MadsGadeberg/MG-Gadget/Diagram/MG-Gadget Diagram.png

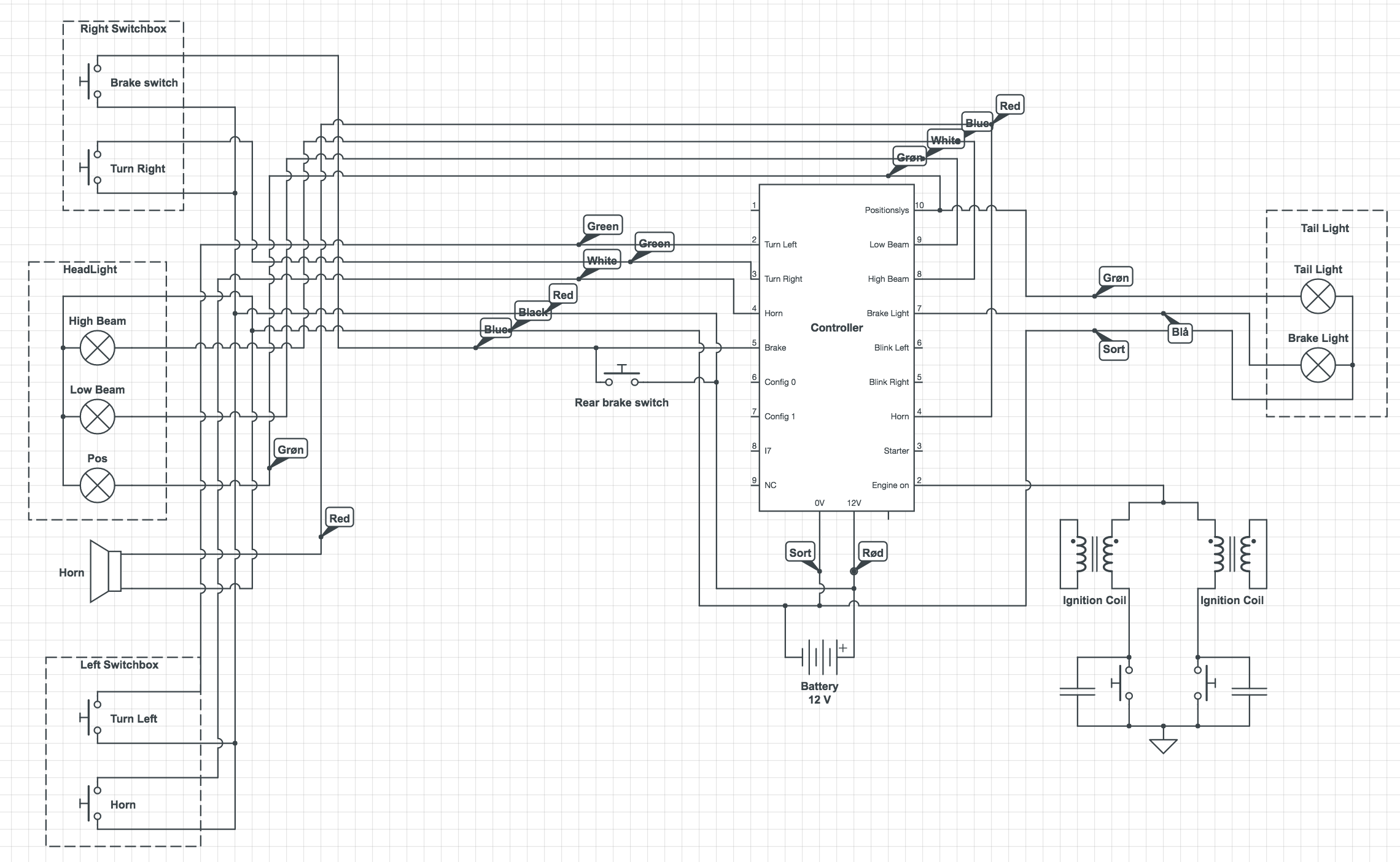
Diagram/MG-Gadget Diagram.png
