MadsGadeberg/MG-Gadget/Diagram/CB400F Diagram.pdf

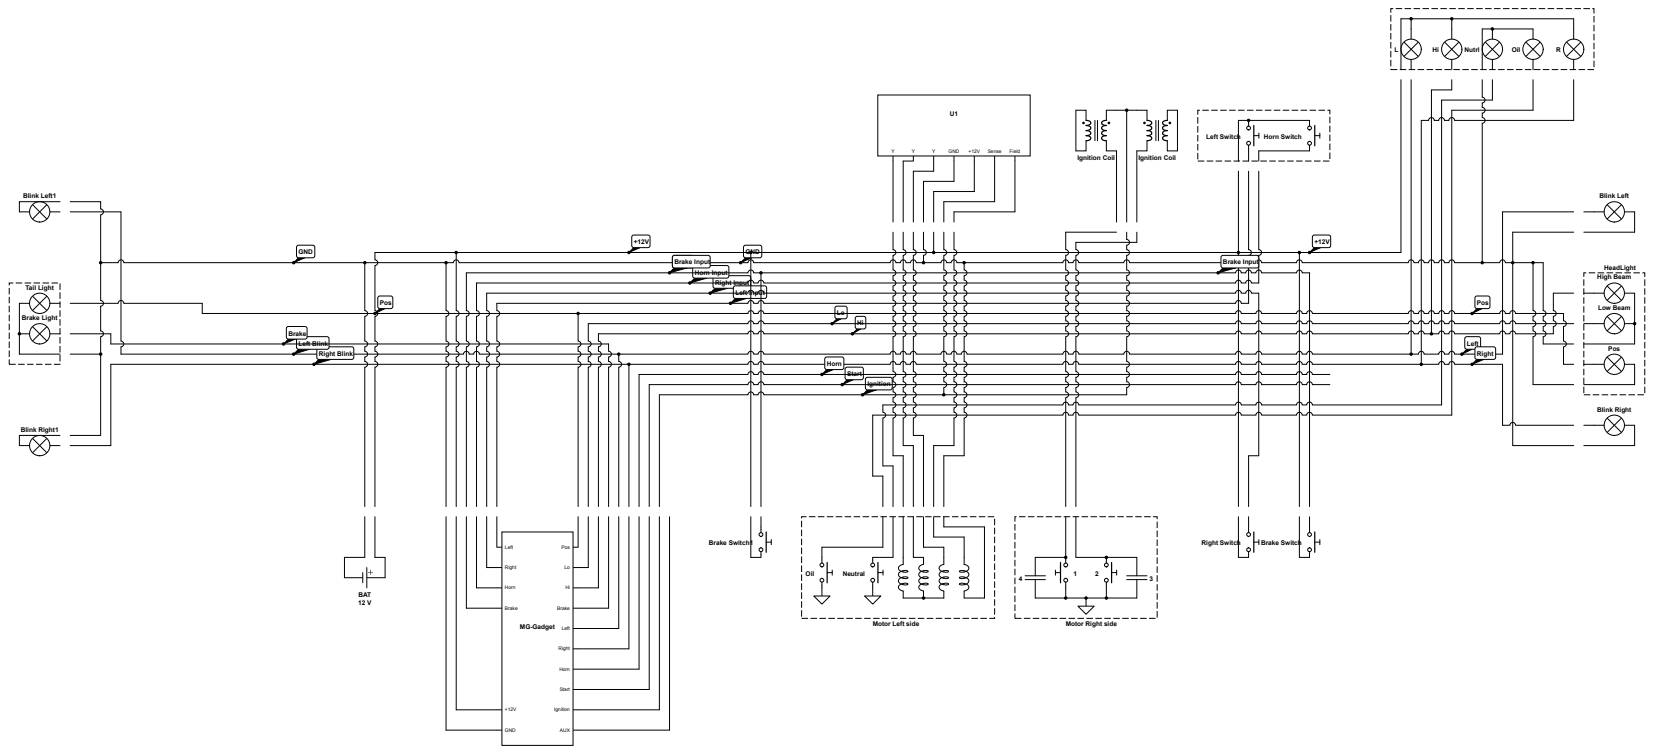
[picture p2: page 1]
GND; Sense; Field; Oil; Neutral; Ignition Coil; Motor Left side; Motor Right side; BAT 12 V; MG-Gadget; Left; Brake; Horn; Right; Pos; Start; Ignition; AUX; Right Input; Left Input; Horn Input; Right Blink; Left Blink; Brake Input; Low Beam; HeadLight High Beam; Tail Light; Brake Light; Blink Right; Blink Left; Left Switch; Horn Switch; Brake Switch1; Right Switch; Brake Switch; Blink Left1; Blink Right1; Nutrl
