MadsGadeberg/MG-Gadget/Diagram/MG-Gadget Diagram.pdf

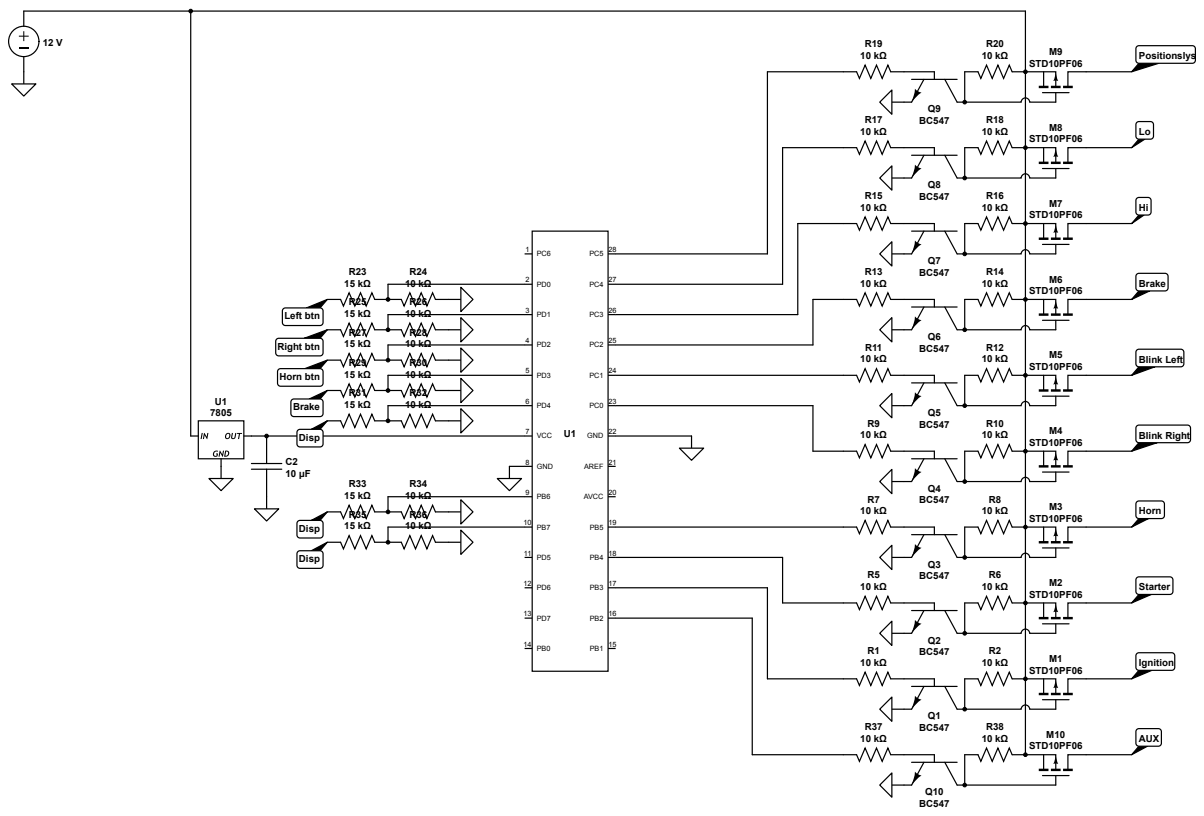
[picture p3: page 1]
