MadsGadeberg/MG-Gadget/Diagram/Old documents/CB400F Diagram.old.pdf

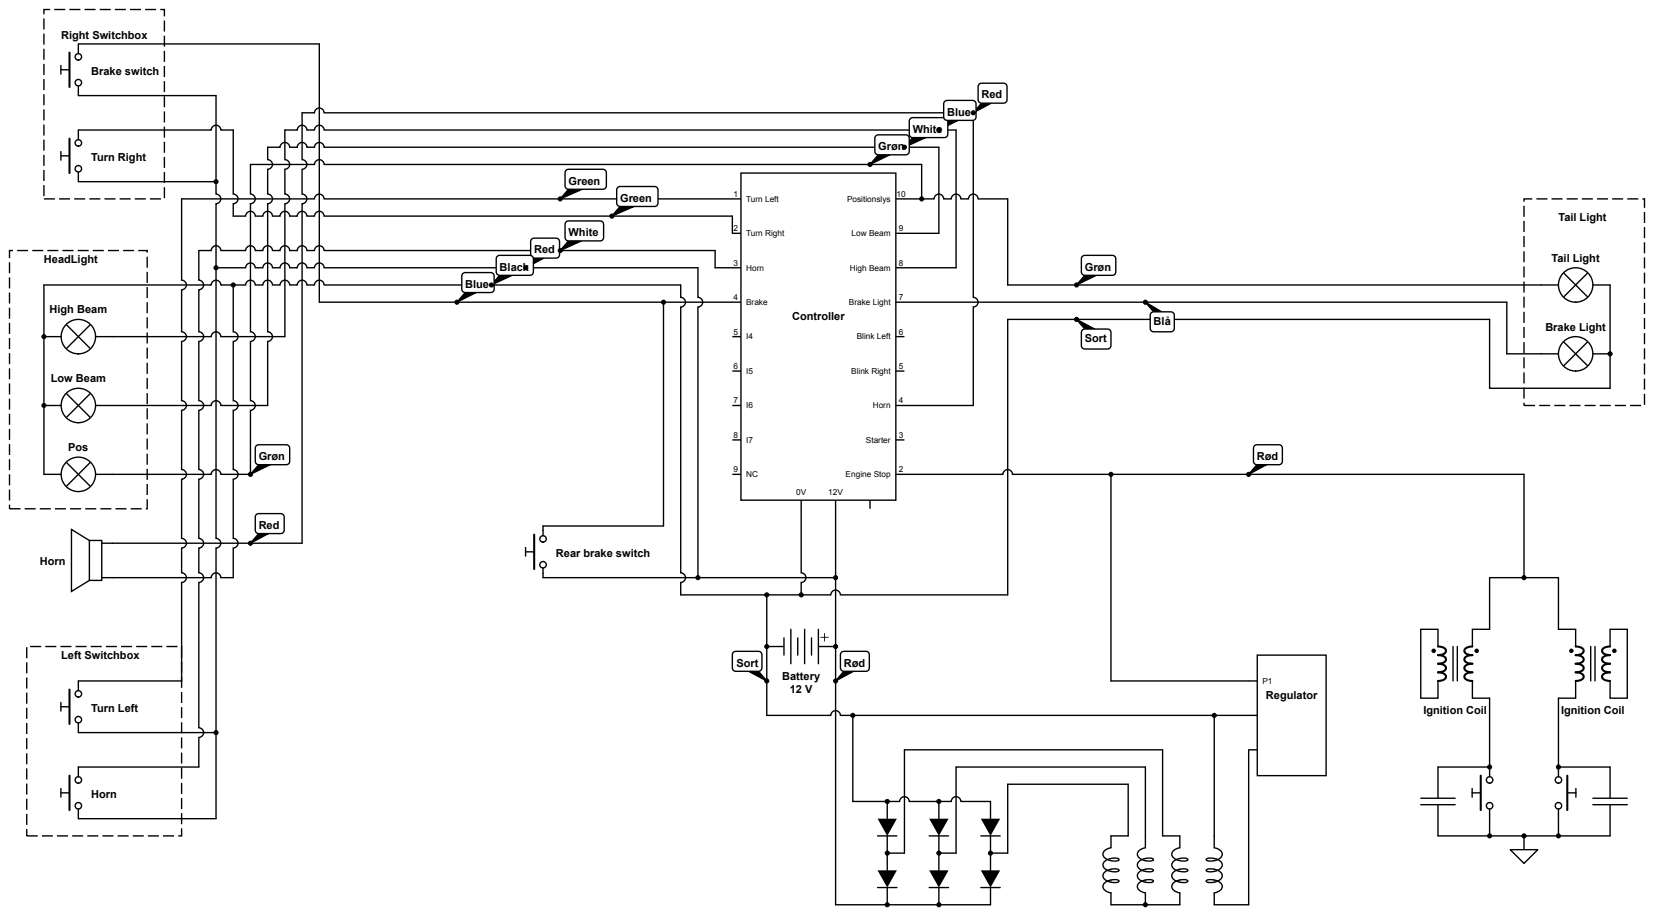
[picture p4: page 1]
Controller; Turn Left 1; Turn Right 2; Horn 3; Brake 4; Positionslys 10; Low Beam 9; High Beam 8; Brake Light 7; Blink Left 6; Blink Right 5; Horn 4; Starter 3; Engine Stop 2; Turn Left; Turn Right; Horn; Battery 12 V; High Beam; Low Beam; Pos; HeadLight; Left Switchbox; Right Switchbox; Tail Light; Brake Light; Brake switch; Ignition Coil; Regulator; Rød; Grøn; Sort; Blå; White; Blue; Red; Black; Green

Rear brake switch
