MadsGadeberg/MG-Gadget/Diagram/Old documents/MG-Gadget_diagram.outdated.pdf

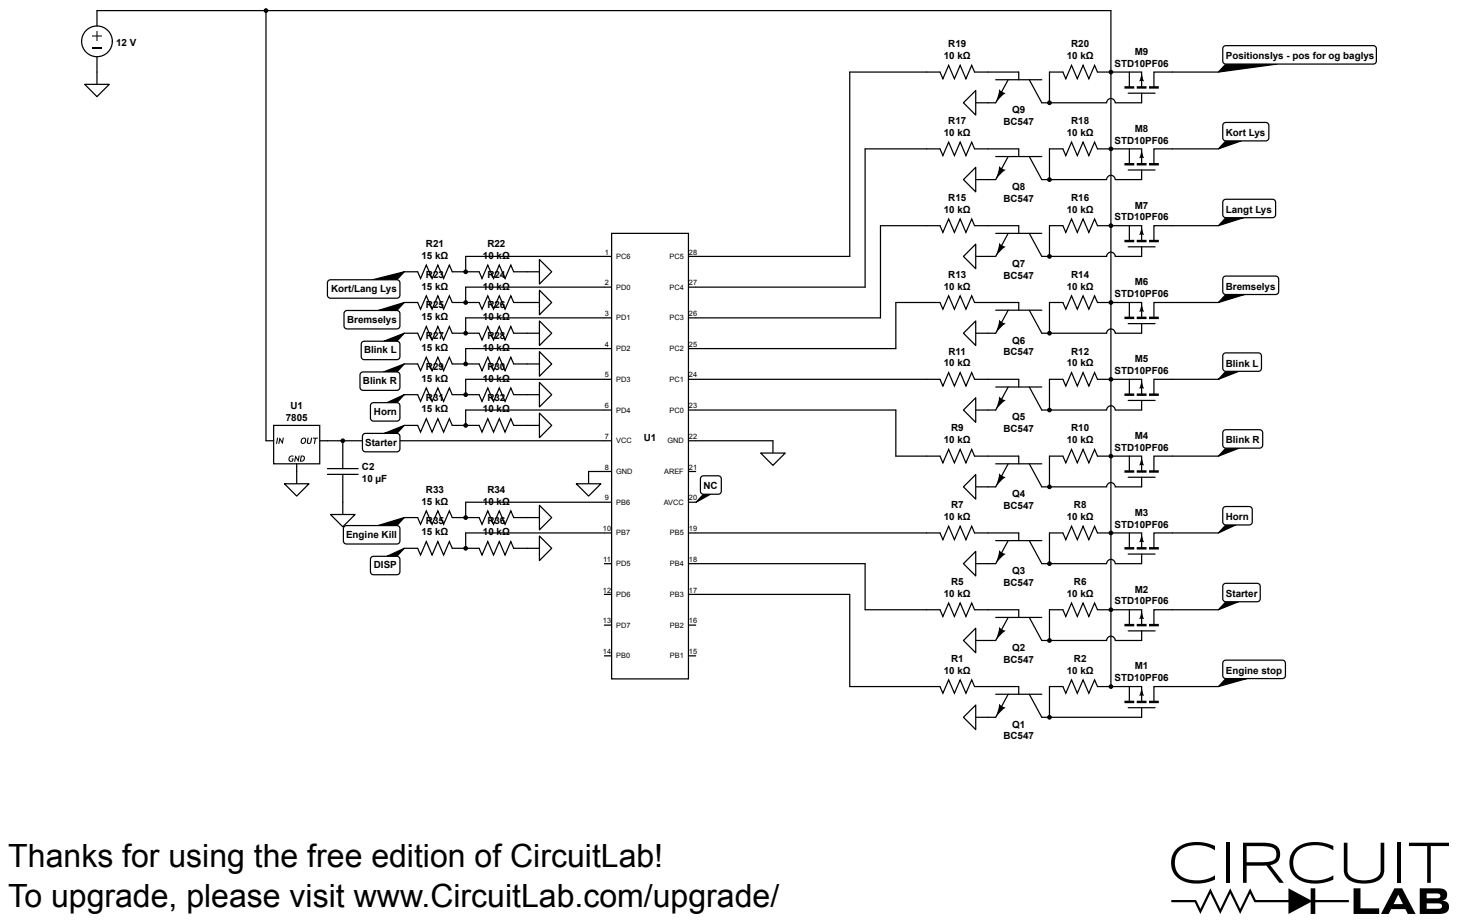
[picture p5: page 1]

Thanks for using the free edition of CircuitLab!
To upgrade, please visit www.CircuitLab.com/upgrade/
