MadsGadeberg/MG-Gadget/Eagle Projects/MG-Gadget arduino pro mini/MG-Gadget mini.sch

## EAGLE design Eagle Projects/MG-Gadget arduino pro mini/MG-Gadget mini.sch (2016-07-11)

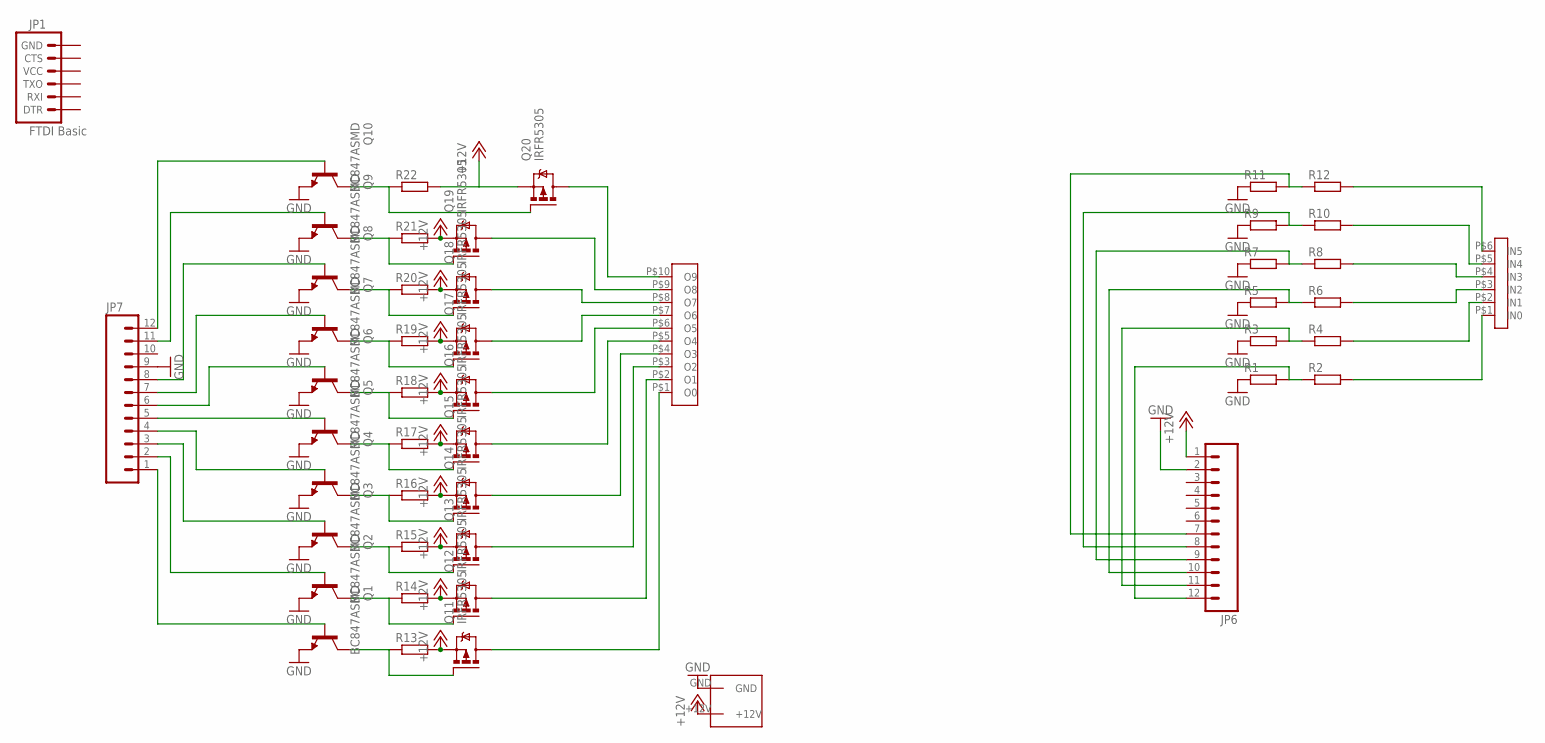
[picture p6: schematic MG-Gadget mini.sch]

Parts:
JP1: FTDI Basic; 1X06
JP6, JP7: M12PTH; 1X12
Q1, Q2, Q3, Q4, Q5, Q6, Q7, Q8, Q9, Q10: BC847ASMD; SOT23
Q11, Q12, Q13, Q14, Q15, Q16, Q17, Q18, Q19, Q20: IRFR5305; D-PAK_TO252AA
R1, R2, R3, R4, R5, R6, R7, R8, R9, R10, R11, R12, R13, R14, R15, R16, R17, R18, R19, R20, R21, R22: R-EU_R0805; R0805
U$1: INTERMINAL
U$2: OUTTERMINAL
U$3: SUPPLYTERMINAL

Connections:
+12V: JP6.1, Q11.3 (S), Q12.3 (S), Q13.3 (S), Q14.3 (S), Q15.3 (S), Q16.3 (S), Q17.3 (S), Q18.3 (S), Q19.3 (S), Q20.3 (S), R13.2, R14.2, R15.2, R16.2, R17.2, R18.2, R19.2, R20.2, R21.2, R22.2, U$3.+12V
GND: JP6.2, JP7.9, Q1.2 (E), Q2.2 (E), Q3.2 (E), Q4.2 (E), Q5.2 (E), Q6.2 (E), Q7.2 (E), Q8.2 (E), Q9.2 (E), Q10.2 (E), R1.1, R3.1, R5.1, R7.1, R9.1, R11.1, U$3.GND
unnamed: JP6.12, R1.2, R2.1
unnamed: JP6.11, R3.2, R4.1
unnamed: R2.2, U$1.P$1 (IN0)
unnamed: R4.2, U$1.P$2 (IN1)
unnamed: Q1.3 (C), Q11.1 (G), R13.1
unnamed: JP6.10, R5.2, R6.1
unnamed: R6.2, U$1.P$3 (IN2)
unnamed: R8.2, U$1.P$4 (IN3)
unnamed: R10.2, U$1.P$5 (IN4)
unnamed: R12.2, U$1.P$6 (IN5)
unnamed: JP6.7, R11.2, R12.1
unnamed: JP6.8, R9.2, R10.1
unnamed: JP6.9, R7.2, R8.1
unnamed: Q2.3 (C), Q12.1 (G), R14.1
unnamed: JP7.1, Q1.1 (B)
unnamed: JP7.2, Q2.1 (B)
unnamed: Q3.3 (C), Q13.1 (G), R15.1
unnamed: Q4.3 (C), Q14.1 (G), R16.1
unnamed: JP7.3, Q3.1 (B)
unnamed: JP7.4, Q4.1 (B)
unnamed: JP7.5, Q5.1 (B)
unnamed: JP7.6, Q6.1 (B)
unnamed: Q20.4 (D), U$2.P$10 (O9)
unnamed: JP7.7, Q7.1 (B)
unnamed: JP7.8, Q8.1 (B)
unnamed: JP7.11, Q9.1 (B)
unnamed: JP7.12, Q10.1 (B)
unnamed: Q8.3 (C), Q18.1 (G), R20.1
unnamed: Q10.3 (C), Q20.1 (G), R22.1
unnamed: Q9.3 (C), Q19.1 (G), R21.1
unnamed: Q7.3 (C), Q17.1 (G), R19.1
unnamed: Q6.3 (C), Q16.1 (G), R18.1
unnamed: Q5.3 (C), Q15.1 (G), R17.1
unnamed: Q11.4 (D), U$2.P$1 (O0)
unnamed: Q12.4 (D), U$2.P$2 (O1)
unnamed: Q13.4 (D), U$2.P$3 (O2)
unnamed: Q14.4 (D), U$2.P$4 (O3)
unnamed: Q15.4 (D), U$2.P$5 (O4)
unnamed: Q16.4 (D), U$2.P$6 (O5)
unnamed: Q17.4 (D), U$2.P$7 (O6)
unnamed: Q18.4 (D), U$2.P$8 (O7)
unnamed: Q19.4 (D), U$2.P$9 (O8)
