MadsGadeberg/MG-Gadget/Eagle Projects/MG-Gadget/MG-Gadget.sch

## EAGLE design Eagle Projects/MG-Gadget/MG-Gadget.sch (2016-07-08)

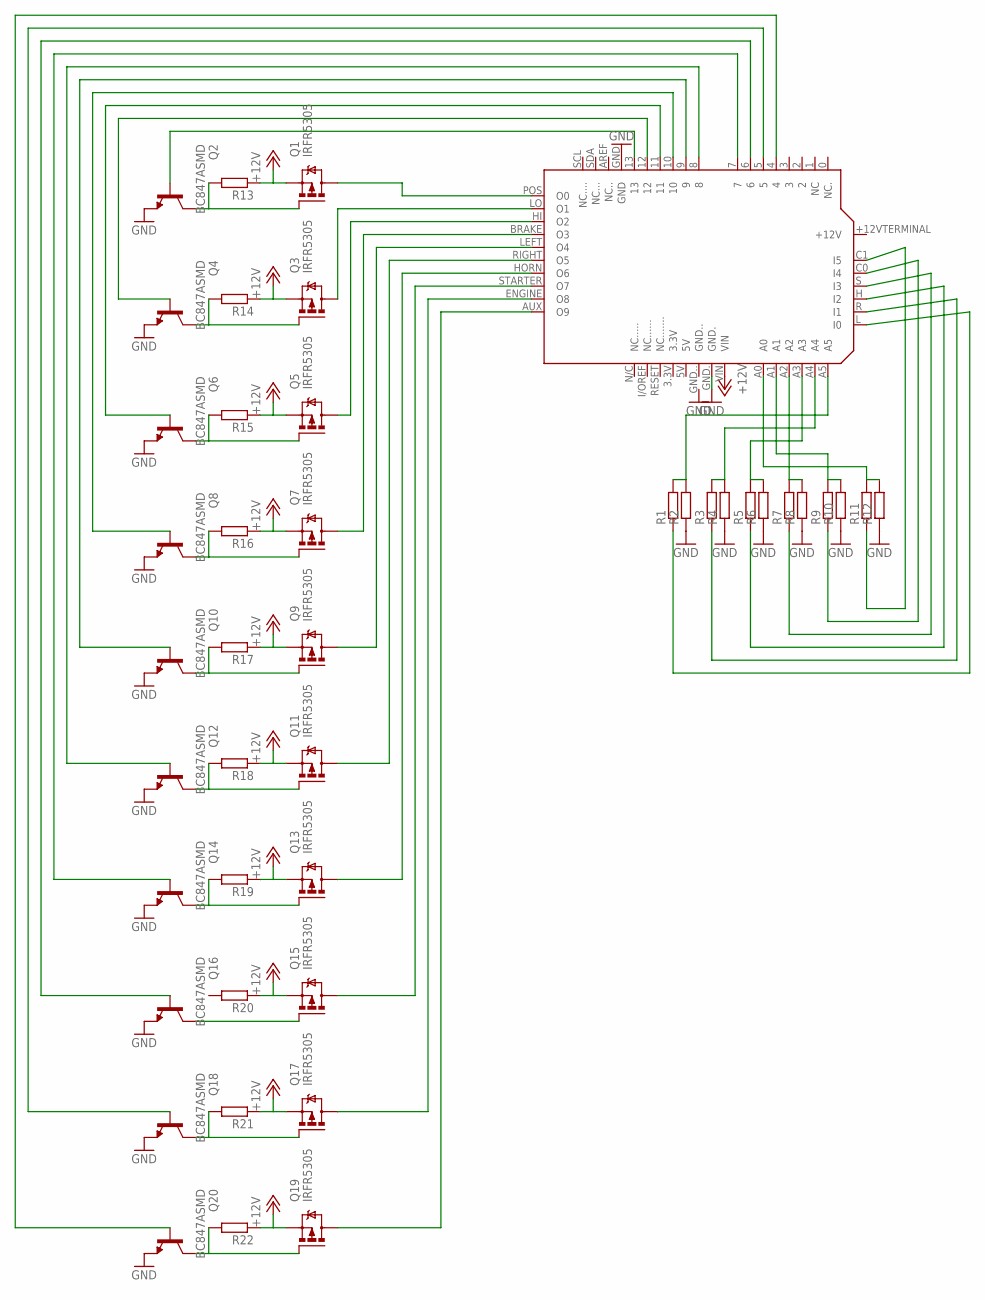
[picture p7: schematic MG-Gadget.sch]

Parts:
PCB1: ARDUINO_UNO
Q1, Q3, Q5, Q7, Q9, Q11, Q13, Q15, Q17, Q19: IRFR5305; D-PAK_TO252AA
Q2, Q4, Q6, Q8, Q10, Q12, Q14, Q16, Q18, Q20: BC847ASMD; SOT23
R1, R2, R3, R4, R5, R6, R7, R8, R9, R10, R11, R12, R13, R14, R15, R16, R17, R18, R19, R20, R21, R22: R-EU_R0805; R0805

Connections:
+12V: PCB1.VIN, Q1.3 (S), Q3.3 (S), Q5.3 (S), Q7.3 (S), Q9.3 (S), Q11.3 (S), Q13.3 (S), Q15.3 (S), Q17.3 (S), Q19.3 (S), R13.1, R14.1, R15.1, R16.1, R17.1, R18.1, R19.1, R20.1, R21.1, R22.1
GND: PCB1.GND, PCB1.GND., Q2.2 (E), Q4.2 (E), Q6.2 (E), Q8.2 (E), Q10.2 (E), Q12.2 (E), Q14.2 (E), Q16.2 (E), Q18.2 (E), Q20.2 (E), R2.1, R4.1, R6.1, R8.1, R10.1, R12.1
unnamed: PCB1.A5, R1.2, R2.2
unnamed: PCB1.A4, R3.2, R4.2
unnamed: PCB1.A3, R5.2, R6.2
unnamed: PCB1.A2, R7.2, R8.2
unnamed: PCB1.A1, R9.2, R10.2
unnamed: PCB1.A0, R11.2, R12.2
unnamed: PCB1.C1 (I5), R11.1
unnamed: PCB1.C0 (I4), R9.1
unnamed: PCB1.S (I3), R7.1
unnamed: PCB1.H (I2), R5.1
unnamed: PCB1.R (I1), R3.1
unnamed: PCB1.L (I0), R1.1
unnamed: Q1.1 (G), Q2.3 (C), R13.2
unnamed: PCB1.POS (O0), Q1.4 (D)
unnamed: Q3.1 (G), Q4.3 (C), R14.2
unnamed: Q5.1 (G), Q6.3 (C), R15.2
unnamed: PCB1.13, Q2.1 (B)
unnamed: Q7.1 (G), Q8.3 (C), R16.2
unnamed: PCB1.12, Q4.1 (B)
unnamed: Q9.1 (G), Q10.3 (C), R17.2
unnamed: PCB1.11, Q6.1 (B)
unnamed: Q11.1 (G), Q12.3 (C), R18.2
unnamed: PCB1.10, Q8.1 (B)
unnamed: Q13.1 (G), Q14.3 (C), R19.2
unnamed: PCB1.9, Q10.1 (B)
unnamed: Q15.1 (G), Q16.3 (C)
unnamed: PCB1.8, Q12.1 (B)
unnamed: Q17.1 (G), Q18.3 (C), R21.2
unnamed: PCB1.7, Q14.1 (B)
unnamed: Q19.1 (G), Q20.3 (C), R22.2
unnamed: PCB1.6, Q16.1 (B)
unnamed: PCB1.LO (O1), Q3.4 (D)
unnamed: PCB1.HI (O2), Q5.4 (D)
unnamed: PCB1.BRAKE (O3), Q7.4 (D)
unnamed: PCB1.LEFT (O4), Q9.4 (D)
unnamed: PCB1.RIGHT (O5), Q11.4 (D)
unnamed: PCB1.HORN (O6), Q13.4 (D)
unnamed: PCB1.STARTER (O7), Q15.4 (D)
unnamed: PCB1.ENGINE (O8), Q17.4 (D)
unnamed: PCB1.AUX (O9), Q19.4 (D)
unnamed: PCB1.5, Q18.1 (B)
unnamed: PCB1.4, Q20.1 (B)
