MadsGadeberg/MG-Gadget/(commit log)

2016-06-18 Initial commit, that contains a final version of the software besides some Arduino functionalities that should be fixed before uploading to the chip. This code is meant for an arduino that shares the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
    [CB400F.ino, motorcycle.cpp, motorcycle.h]
2016-06-21 Added drawings of the motorcycle and the controller board.
2016-06-24 Cleanup and small fixes
    [motorcycle.cpp]
2016-06-28 Updated pin numbers and cleaned for temporary test settings
2016-06-28 Repo Clean, Added board drawings.
2016-06-29 Fixed Config input functionality and some mort numbering for Arduino uno usage.
    [motorcycle.cpp, motorcycle.h]
2016-06-29 Smarter port filter edits
2016-07-08 Added Eagle projects of Arduino shield
    [MG-Gadget.brd, MG-Gadget.sch]
2016-07-11 New smaller PCB board using Arduino Pro Mini
    [MG-Gadget mini.brd, MG-Gadget mini.sch]
2016-07-26 Target pin numbering update, along with deleting of serial messages for debugging
